GiuseppeTrainiti/MetalDetector/README.md

# MetalDetector

In order to open the code you need to have MDK-ARM Keil installed.
Once you install it, you can open the project:

Metaldetector/Code/Metaldetector/MDK-ARM/metalDetector_comInterface.uvprojx
