GiuseppeTrainiti/MetalDetector/KiCad/MetalDetector/MetalDetector.kicad_pcb

## KiCad design KiCad/MetalDetector/MetalDetector.kicad_pcb (2025-04-04)

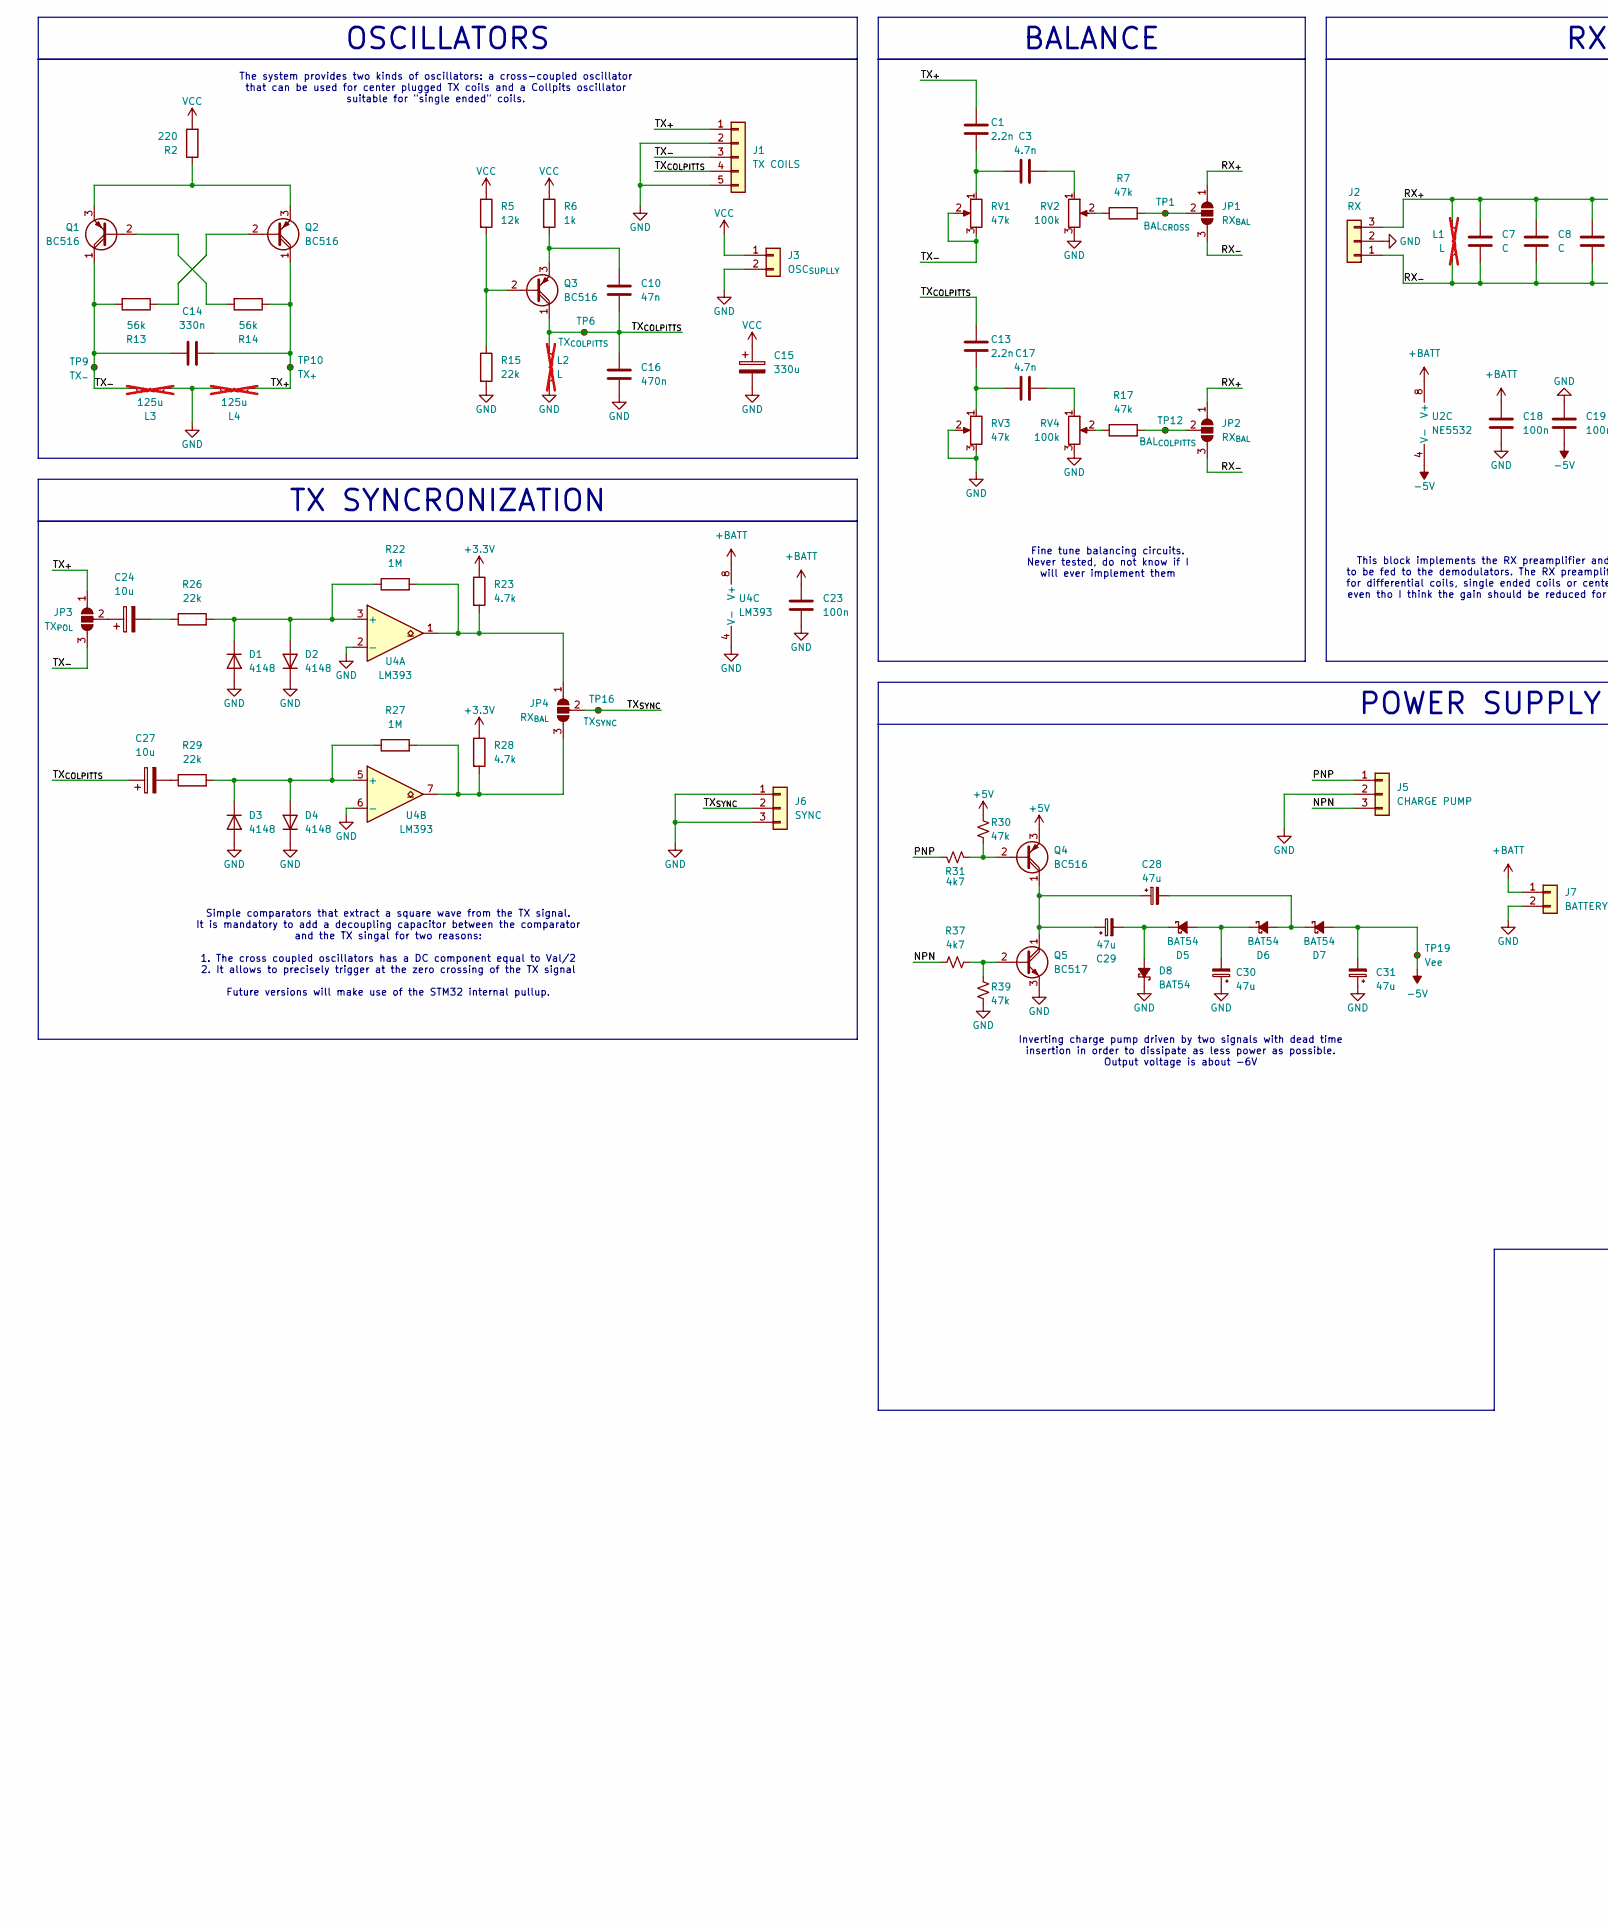
[picture p1: schematic MetalDetector.kicad_sch, VLF Metal Detector, part in row 1, column 1]

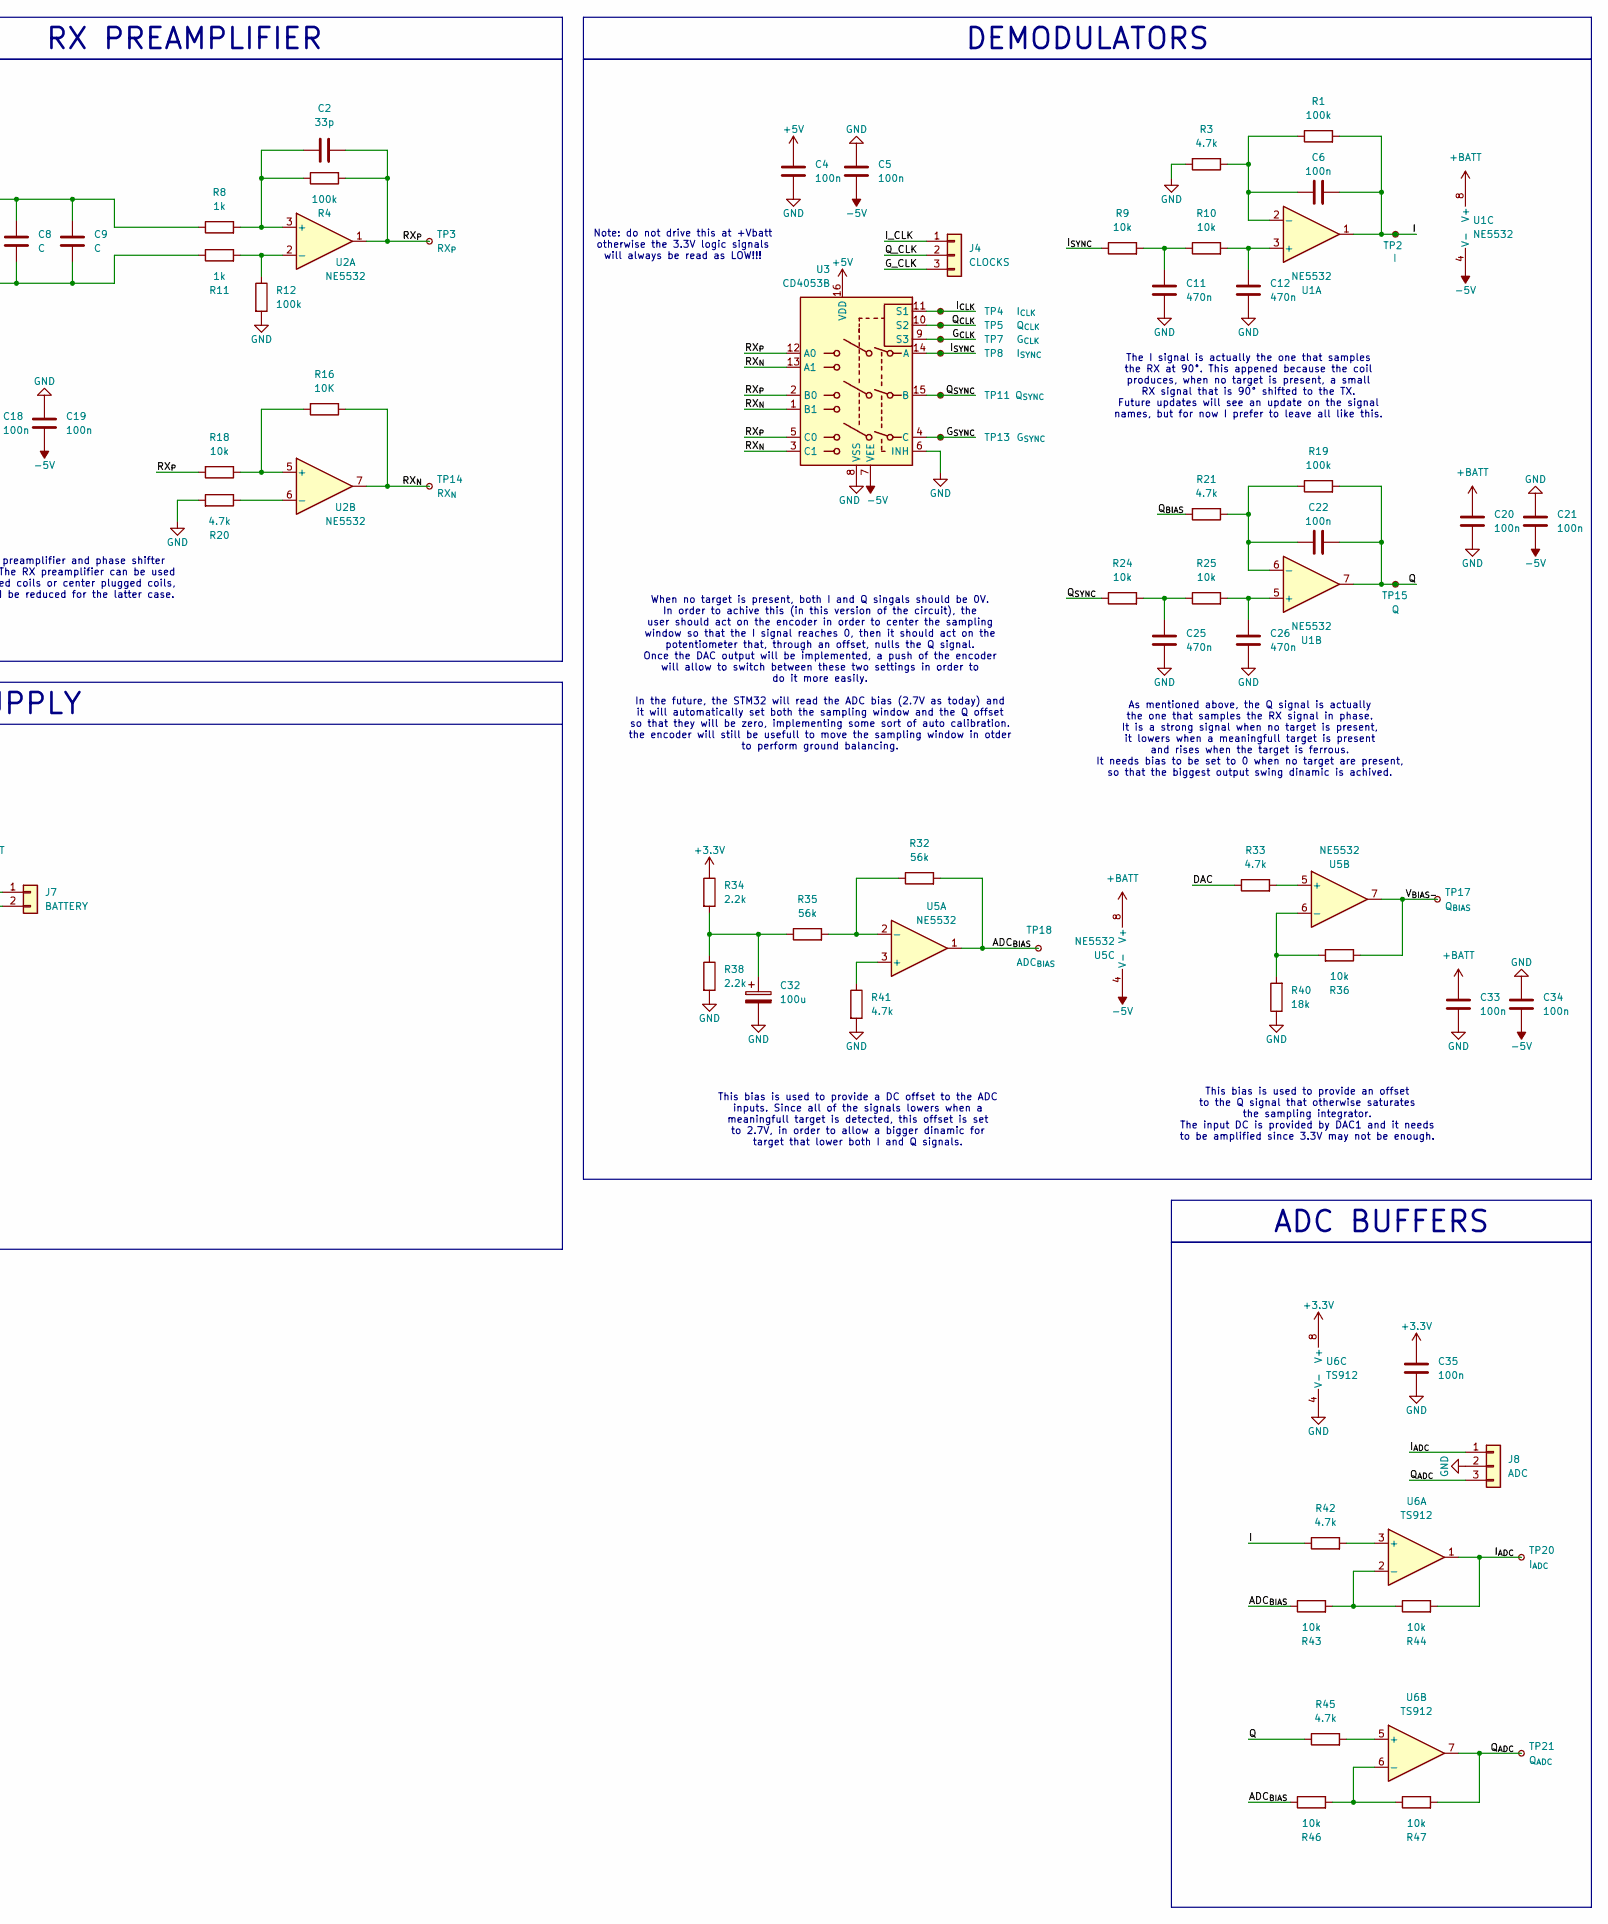
[picture p2: schematic MetalDetector.kicad_sch, VLF Metal Detector, part in row 1, column 2]

Parts:
C1, C13: 2.2n; C_0603_1608Metric_Pad1.08x0.95mm_HandSolder
C2: 33p; C_0603_1608Metric_Pad1.08x0.95mm_HandSolder
C3, C17: 4.7n; C_0603_1608Metric_Pad1.08x0.95mm_HandSolder
C4, C5, C6, C18, C19, C20, C21, C22, C23, C33, C34, C35: 100n; C_0603_1608Metric_Pad1.08x0.95mm_HandSolder
C7, C8, C9: C; C_0603_1608Metric_Pad1.08x0.95mm_HandSolder
C10: 47n; C_0603_1608Metric_Pad1.08x0.95mm_HandSolder
C11, C12, C25, C26: 470n; C_0603_1608Metric_Pad1.08x0.95mm_HandSolder
C14: 330n; C_1812_4532Metric_Pad1.57x3.40mm_HandSolder
C15: 330u; CP_Elec_16x22
C16: 470n; C_1206_3216Metric_Pad1.33x1.80mm_HandSolder
C24, C27: 10u; CP_Elec_5x5.4
C28, C29, C30, C31: 47u; CP_Elec_5x5.4
C32: 100u; CP_Elec_5x5.4
D1, D2, D3, D4: 4148; D_SOD-323F
D5, D6, D7, D8: BAT54; D_SOD-323F
J1: TX COILS
J2: RX
J3: OSC_{SUPLLY}
J4: CLOCKS
J5: CHARGE PUMP
J6: SYNC
J7: BATTERY
J8: ADC
JP1, JP2, JP4: RX_{BAL}; SolderJumper-3_P1.3mm_Open_RoundedPad1.0x1.5mm
JP3: TX_{POL}; SolderJumper-3_P1.3mm_Open_RoundedPad1.0x1.5mm
L1, L2: L; not fitted
L3, L4: 125u; not fitted
Q1, Q2, Q3: BC516; TO-92
Q4: BC516; SOT-23-3
Q5: BC517; SOT-23-3
R1, R4, R12, R19: 100k; R_0603_1608Metric_Pad0.98x0.95mm_HandSolder
R2: 220; R_1206_3216Metric_Pad1.30x1.75mm_HandSolder
R3, R20, R21, R23, R28, R33, R41, R42, R45: 4.7k; R_0603_1608Metric_Pad0.98x0.95mm_HandSolder
R5: 12k; R_0603_1608Metric_Pad0.98x0.95mm_HandSolder
R6: 1k; R_1206_3216Metric_Pad1.30x1.75mm_HandSolder
R7, R17, R30, R39: 47k; R_0603_1608Metric_Pad0.98x0.95mm_HandSolder
R8, R11: 1k; R_0603_1608Metric_Pad0.98x0.95mm_HandSolder
R9, R10, R18, R24, R25, R36, R43, R44, R46, R47: 10k; R_0603_1608Metric_Pad0.98x0.95mm_HandSolder
R13, R14, R32, R35: 56k; R_0603_1608Metric_Pad0.98x0.95mm_HandSolder
R15, R26, R29: 22k; R_0603_1608Metric_Pad0.98x0.95mm_HandSolder
R16: 10K; R_0603_1608Metric_Pad0.98x0.95mm_HandSolder
R22, R27: 1M; R_0603_1608Metric_Pad0.98x0.95mm_HandSolder
R31, R37: 4k7; R_0603_1608Metric_Pad0.98x0.95mm_HandSolder
R34, R38: 2.2k; R_0603_1608Metric_Pad0.98x0.95mm_HandSolder
R40: 18k; R_0603_1608Metric_Pad0.98x0.95mm_HandSolder
RV1, RV3: 47k; Potentiometer_Bourns_3269W_Vertical
RV2, RV4: 100k; Potentiometer_Bourns_3269W_Vertical
TP1: BAL_{CROSS}; TestPoint_Keystone_5010-5014_Multipurpose
TP2: I; TestPoint_Keystone_5010-5014_Multipurpose
TP3: RX_{P}; TestPoint_Keystone_5010-5014_Multipurpose
TP4: I_{CLK}; TestPoint_Keystone_5010-5014_Multipurpose
TP5: Q_{CLK}; TestPoint_Keystone_5010-5014_Multipurpose
TP6: TX_{COLPITTS}; TestPoint_Keystone_5010-5014_Multipurpose
TP7: G_{CLK}; TestPoint_Keystone_5010-5014_Multipurpose
TP8: I_{SYNC}; TestPoint_Keystone_5010-5014_Multipurpose
TP9: TX_{-}; TestPoint_Keystone_5010-5014_Multipurpose
TP10: TX_{+}; TestPoint_Keystone_5010-5014_Multipurpose
TP11: Q_{SYNC}; TestPoint_Keystone_5010-5014_Multipurpose
TP12: BAL_{COLPITTS}; TestPoint_Keystone_5010-5014_Multipurpose
TP13: G_{SYNC}; TestPoint_Keystone_5010-5014_Multipurpose
TP14: RX_{N}; TestPoint_Keystone_5010-5014_Multipurpose
TP15: Q; TestPoint_Keystone_5010-5014_Multipurpose
TP16: TX_{SYNC}; TestPoint_Keystone_5010-5014_Multipurpose
TP17: Q_{BIAS}; TestPoint_Keystone_5010-5014_Multipurpose
TP18: ADC_{BIAS}; TestPoint_Keystone_5010-5014_Multipurpose
TP19: Vee; TestPoint_Keystone_5010-5014_Multipurpose
TP20: I_{ADC}; TestPoint_Keystone_5010-5014_Multipurpose
TP21: Q_{ADC}; TestPoint_Keystone_5010-5014_Multipurpose
U1, U2, U5: NE5532; SOIC-8_3.9x4.9mm_P1.27mm
U3: CD4053B; SOIC-16_3.9x9.9mm_P1.27mm
U4: LM393; SOIC-8_3.9x4.9mm_P1.27mm
U6: TS912; SOIC-8_3.9x4.9mm_P1.27mm

Connections:
+3.3V: C35.1, R23.1, R28.1, R34.1, U6.8 (V+)
+5V: C4.1, Q4.3 (E), R30.1, U3.16 (VDD)
+BATT: C18.1, C20.1, C23.1, C33.1, J7.1, U1.8 (V+), U2.8 (V+), U4.8 (V+), U5.8 (V+)
-5V: C5.2, C19.2, C21.2, C31.2, C34.2, D7.2 (A), TP19.1, U1.4 (V-), U2.4 (V-), U3.7 (VEE), U5.4 (V-)
/ADC_{BIAS}: R32.2, R43.1, R46.1, TP18.1, U5.1
/DAC: R33.1
/G_{CLK}: TP7.1, U3.9 (S3)
/G_{SYNC}: TP13.1, U3.4 (C)
/I: C6.2, R1.2, R42.1, TP2.1, U1.1
/I_{ADC}: J8.1, R44.2, TP20.1, U6.1
/I_{CLK}: TP4.1, U3.11 (S1)
/I_{SYNC}: R9.1, TP8.1, U3.14 (A)
/NPN: J5.3, R37.1
/PNP: J5.1, R31.1
/Q: C22.2, R19.2, R45.1, TP15.1, U1.7
/Q_{ADC}: J8.3, R47.2, TP21.1, U6.7
/Q_{BIAS}: R21.2
/Q_{CLK}: TP5.1, U3.10 (S2)
/Q_{SYNC}: R24.1, TP11.1, U3.15 (B)
/RX_{+}: C7.1, C8.1, C9.1, J2.3, JP1.1 (A), JP2.1 (A), L1.1, R8.1
/RX_{-}: C7.2, C8.2, C9.2, J2.1, JP1.3 (B), JP2.3 (B), L1.2, R11.1
/RX_{N}: R16.1, TP14.1, U2.7, U3.1 (B1), U3.3 (C1), U3.13 (A1)
/RX_{P}: C2.2, R4.2, R18.2, TP3.1, U2.1, U3.2 (B0), U3.5 (C0), U3.12 (A0)
/TX_{+}: C1.1, C14.1, J1.1, JP3.1 (A), L4.1, Q2.1 (C), R14.1, TP10.1
/TX_{-}: C14.2, J1.3, JP3.3 (B), L3.2, Q1.1 (C), R13.2, RV1.2, RV1.3, TP9.1
/TX_{COLPITTS}: C10.2, C13.1, C16.1, C27.1, J1.4, L2.1, Q3.1 (C), TP6.1
/TX_{SYNC}: J6.2, JP4.2 (C), TP16.1
/V_{BIAS-}: R36.1, TP17.1, U5.7
GND: C4.2, C5.1, C11.2, C12.2, C15.2, C16.2, C18.2, C19.1, C20.2, C21.1, C23.2, C25.2, C26.2, C30.1, C31.1, C32.2, C33.2, C34.1, C35.2, D1.2 (A), D2.1 (K), D3.2 (A), D4.1 (K), D8.1 (K), J1.2, J1.5, J2.2, J3.2, J5.2, J6.1, J6.3, J7.2, J8.2, L2.2, L3.1, L4.2, Q5.3 (E), R3.2, R12.2, R15.2, R20.2, R38.2, R39.2, R40.1, R41.2, RV2.3, RV3.2, RV3.3, RV4.3, U3.6 (INH), U3.8 (VSS), U4.2 (-), U4.4 (V-), U4.6 (-), U6.4 (V-)
unnamed: C1.2, C3.1, RV1.1
unnamed: C3.2, RV2.1
unnamed: C11.1, R9.2, R10.1
unnamed: C13.2, C17.1, RV3.1
unnamed: C17.2, RV4.1
unnamed: C24.2, R26.1
unnamed: C25.1, R24.2, R25.1
unnamed: C27.2, R29.1
unnamed: C32.1, R34.2, R35.1, R38.1
unnamed: D1.1 (K), D2.2 (A), R22.1, R26.2, U4.3 (+)
unnamed: D3.1 (K), D4.2 (A), R27.1, R29.2, U4.5 (+)
unnamed: C30.2, D5.2 (A), D6.1 (K)
unnamed: C29.2, D5.1 (K), D8.2 (A)
unnamed: C28.2, D6.2 (A), D7.1 (K)
unnamed: JP1.2 (C), R7.2, TP1.1
unnamed: JP2.2 (C), R17.2, TP12.1
unnamed: C24.1, JP3.2 (C)
unnamed: JP4.1 (A), R22.2, R23.2, U4.1
unnamed: JP4.3 (B), R27.2, R28.2, U4.7
unnamed: Q1.2 (B), R14.2
unnamed: Q1.3 (E), Q2.3 (E), R2.1
unnamed: Q2.2 (B), R13.1
unnamed: Q3.2 (B), R5.2, R15.1
unnamed: C10.1, Q3.3 (E), R6.2
unnamed: Q4.2 (B), R30.2, R31.2
unnamed: C28.1, C29.1, Q4.1 (C), Q5.1 (C)
unnamed: Q5.2 (B), R37.2, R39.1
unnamed: R7.1, RV2.2
unnamed: R17.1, RV4.2
unnamed: C12.1, R10.2, U1.3 (+)
unnamed: C6.1, R1.1, R3.1, U1.2 (-)
unnamed: C26.1, R25.2, U1.5 (+)
unnamed: C22.1, R19.1, R21.1, U1.6 (-)
unnamed: C2.1, R4.1, R8.2, U2.3 (+)
unnamed: R11.2, R12.1, U2.2 (-)
unnamed: R16.2, R18.1, U2.5 (+)
unnamed: R20.1, U2.6 (-)
unnamed: R41.1, U5.3 (+)
unnamed: R32.1, R35.2, U5.2 (-)
unnamed: R33.2, U5.5 (+)
unnamed: R36.2, R40.2, U5.6 (-)
unnamed: R42.2, U6.3 (+)
unnamed: R43.2, R44.1, U6.2 (-)
unnamed: R45.2, U6.5 (+)
unnamed: R46.2, R47.1, U6.6 (-)
VCC: C15.1, J3.1, R2.2, R5.1, R6.1

Notes on the sheet:
This bias is used to provide an offset to the Q signal that otherwise saturates the sampling integrator. The input DC is provided by DAC1 and it needs to be amplified since 3.3V may not be enough.
When no target is present, both I and Q singals should be 0V. In order to achive this (in this version of the circuit), the user should act on the encoder in order to center the sampling window so that the I signal reaches 0, then it should act on the potentiometer that, through an offset, nulls th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
Simple comparators that extract a square wave from the TX signal. It is mandatory to add a decoupling capacitor between the comparator and the TX singal for two reasons: 1. The cross coupled oscillators has a DC component equal to Val/2 2. It allows to precisely trigger at the zero crossing of the 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
The system provides two kinds of oscillators: a cross-coupled oscillator that can be used for center plugged TX coils and a Collpits oscillator suitable for "single ended" coils.
This block implements the RX preamplifier and phase shifter to be fed to the demodulators. The RX preamplifier can be used for differential coils, single ended coils or center plugged coils, even tho I think the gain should be reduced for the latter case.
This bias is used to provide a DC offset to the ADC inputs. Since all of the signals lowers when a meaningfull target is detected, this offset is set to 2.7V, in order to allow a bigger dinamic for target that lower both I and Q signals.
Fine tune balancing circuits. Never tested, do not know if I will ever implement them
The I signal is actually the one that samples the RX at 90°. This appened because the coil produces, when no target is present, a small RX signal that is 90° shifted to the TX. Future updates will see an update on the signal names, but for now I prefer to leave all like this.
Inverting charge pump driven by two signals with dead time insertion in order to dissipate as less power as possible. Output voltage is about -6V
Note: do not drive this at +Vbatt otherwise the 3.3V logic signals will always be read as LOW!!!
As mentioned above, the Q signal is actually the one that samples the RX signal in phase. It is a strong signal when no target is present, it lowers when a meaningfull target is present and rises when the target is ferrous. It needs bias to be set to 0 when no target are present, so that the bigges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
ADC BUFFERS
RX PREAMPLIFIER
POWER SUPPLY
OSCILLATORS
TX SYNCRONIZATION
DEMODULATORS
BALANCE

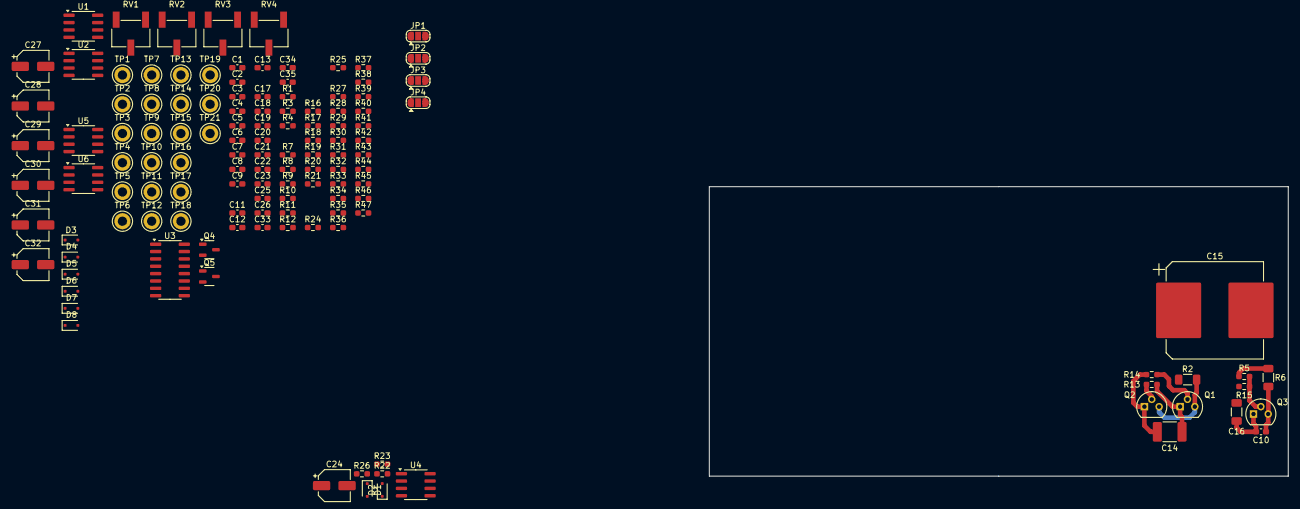
[picture p3: board MetalDetector.kicad_pcb from above]

Board: 4 copper layers, 100.0 x 50.0 mm, 130 parts (0 on the bottom side), 71 nets.
