GiuseppeTrainiti/MetalDetector/Code/MetalDetector/Core/Inc/main.h

#define SWDIO_Pin GPIO_PIN_13
#define SWDIO_GPIO_Port GPIOA
#define SWCLK_Pin GPIO_PIN_14
#define SWCLK_GPIO_Port GPIOA
