GiuseppeTrainiti/MetalDetector/(commit log)

2025-03-29 First push
    [MetalDetector.kicad_pcb, MetalDetector.kicad_sch]
2025-03-30 Push
    Added test points to schematic
    [MetalDetector.kicad_sch]
2025-03-30 Push
    ADC averages
2025-03-30 Push
    Kicad footprint assignment
    [MetalDetector.kicad_sch]
2025-03-31 Push
    Test on self calibration at power on
2025-04-04 Inline calibration
    [MetalDetector.kicad_pcb, MetalDetector.kicad_sch]
